Haipeng-Jiang/unit/plots/unit__Assembly.pdf

+ | - 1 | 2 | 3 | 4 1 | 2 | 3 | 4 ABC | ABC Date: KiCad | E.D.A. 8.0.3 Size: A5 | Rev:

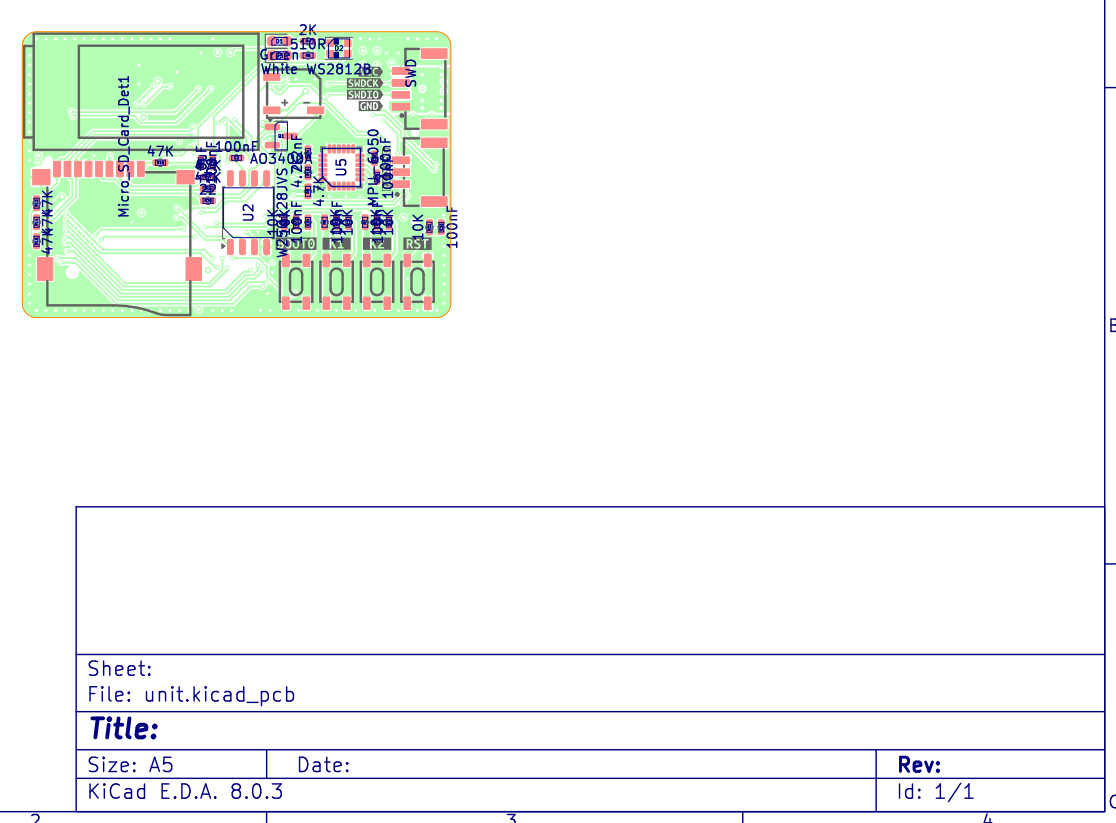
[picture p1: page 1]
Id: 1/1 Title: File: unit.kicad_pcb Sheet:; 4.7KR⁹ 47KR¹³; 100nF C¹ 10KR³Micro_SD_Card_Det1; 100nF C³³ 10KR¹ 100nF C²⁵ 100nF C³⁰; 10KR²² 47KR18; 10KR²³; 10KR² 10KR⁵ 100nF C3; SWDWhite; D3 510RR6 10uFC²⁹; 10KR²¹ 47KR17 22; 100nF C¹⁰ 2.2nF C²⁴ W²⁵Q¹²⁸JVS U²; MPU⁻⁶⁰⁵⁰ U⁵ 4.7KR¹⁰ 47KR¹⁵; 100nF C² Green; 100nF C³⁴ 47KR¹⁴

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

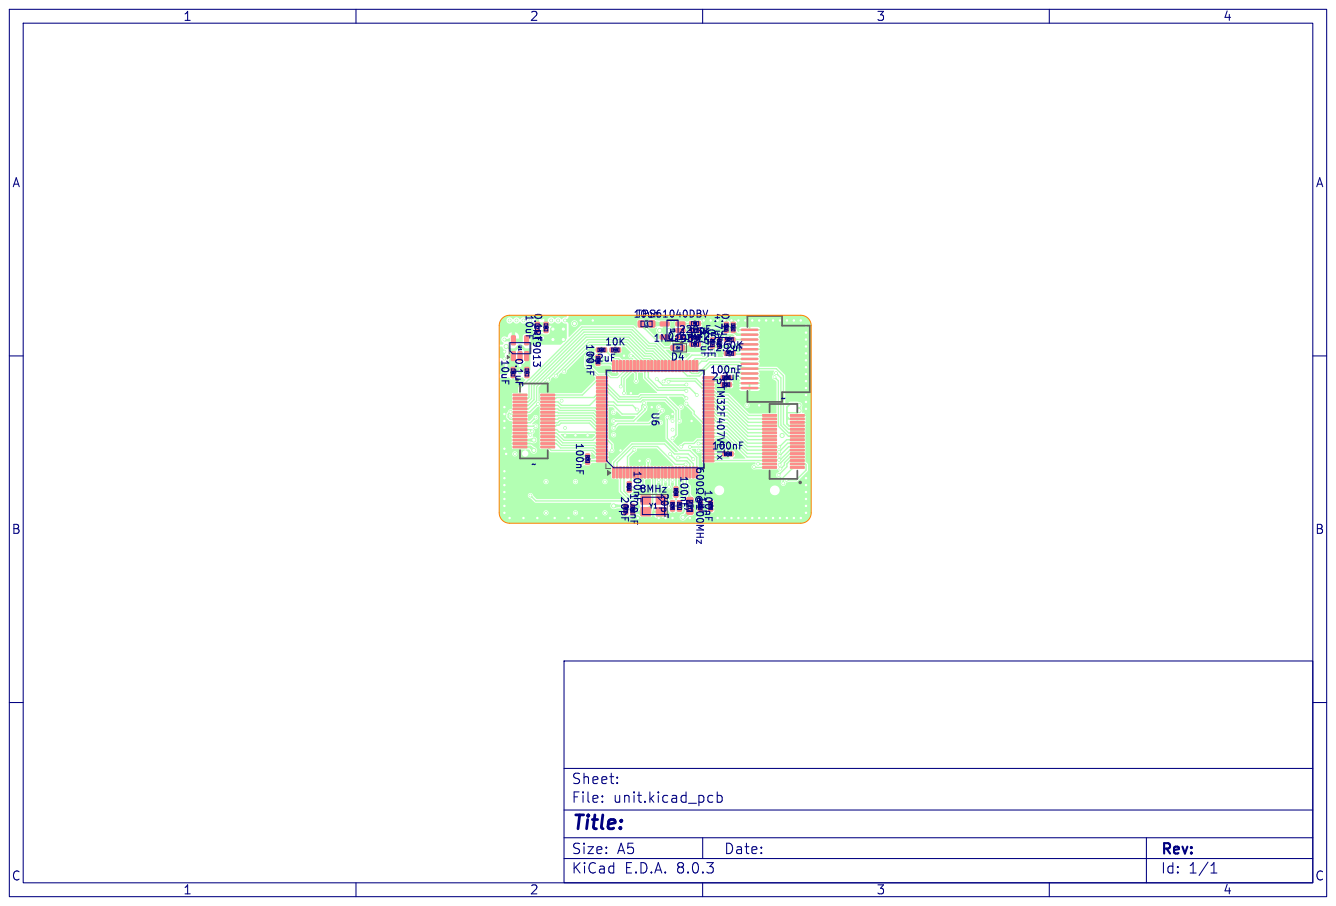
[picture p2: page 2]
