Haipeng-Jiang/unit/unit.pdf

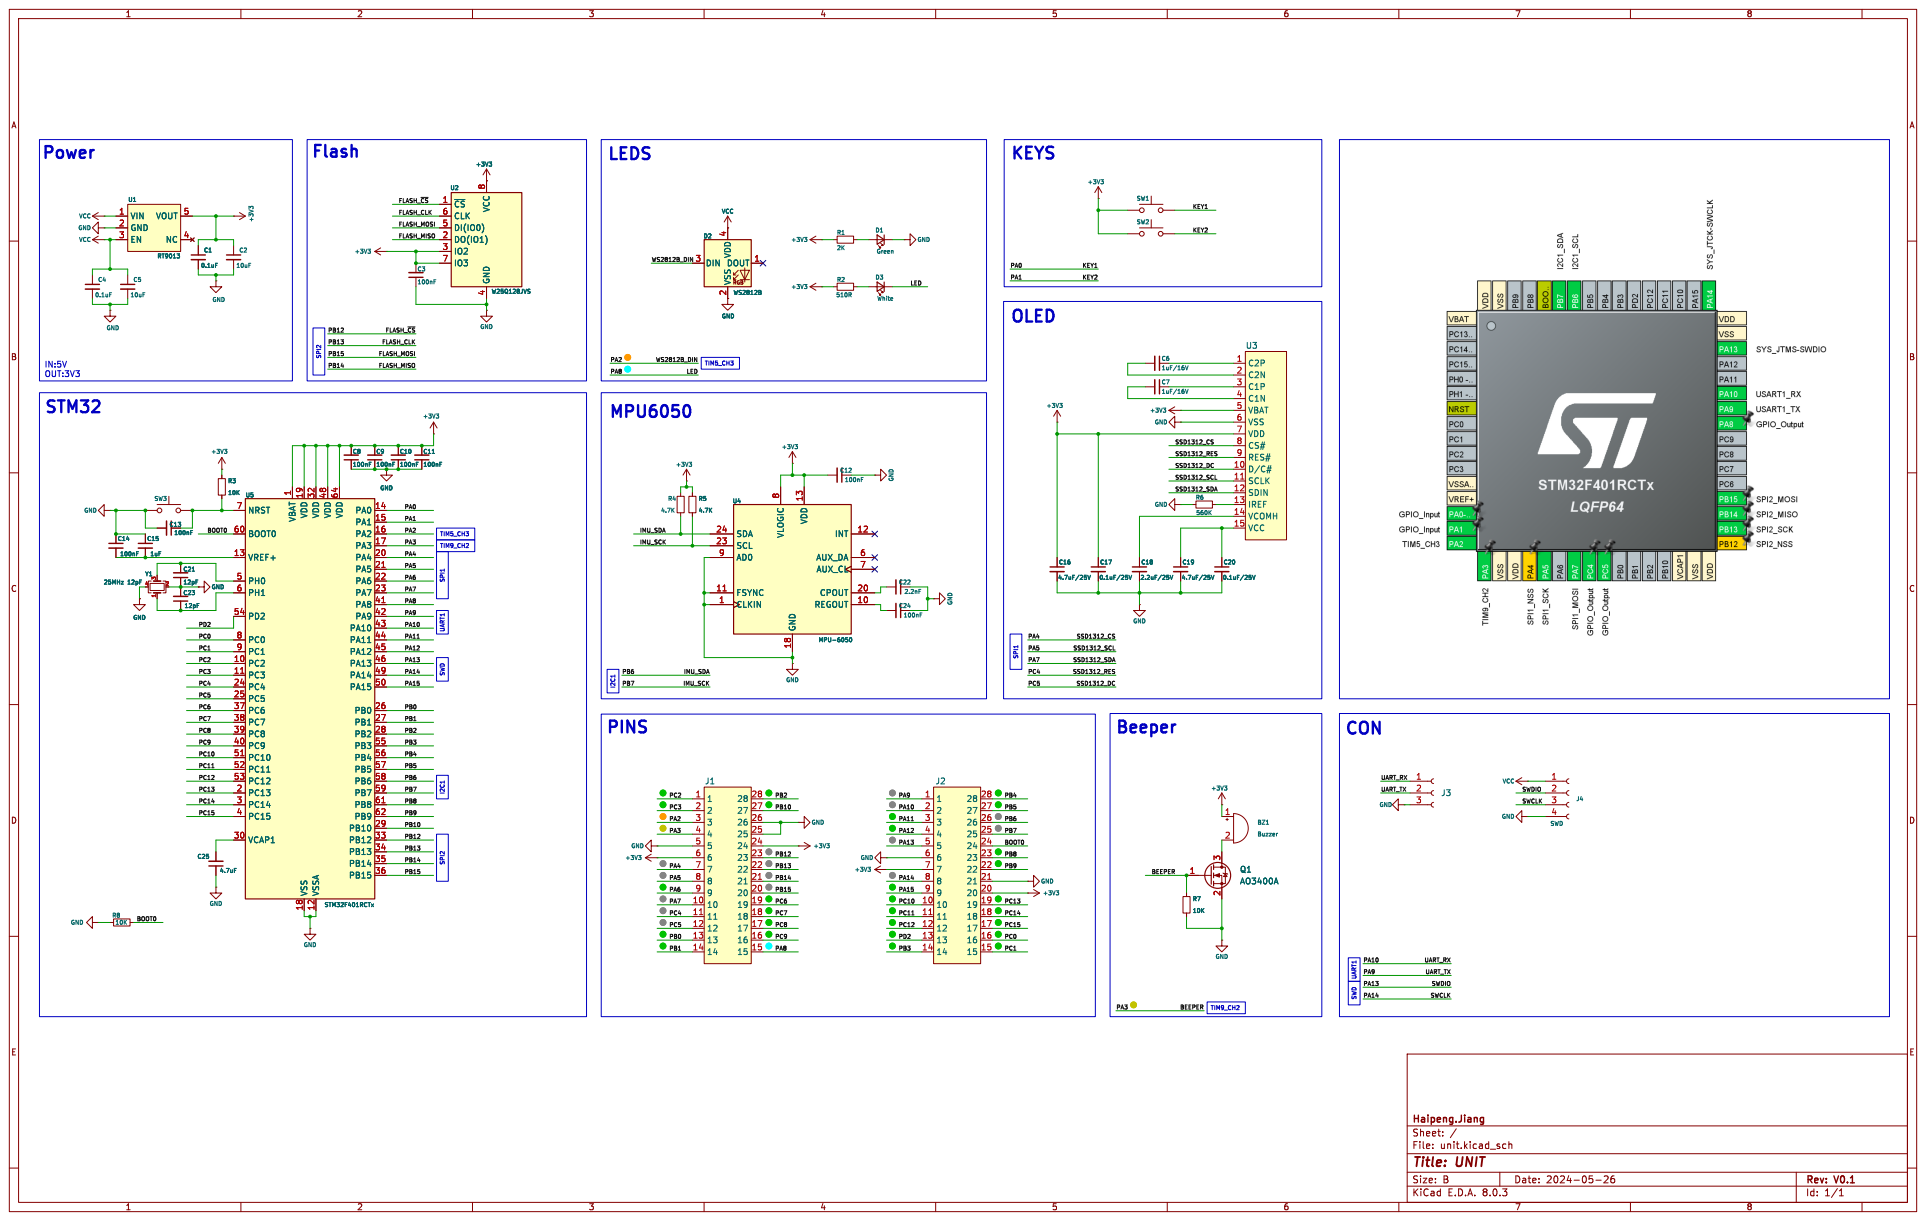
[picture p3: page 1]

File: unit.kicad_sch Sheet: / Haipeng.Jiang +3V3

IREF 13 VCOMH 14 VCC 15 C2N 2 C1P 3 C1N 4 VBAT 5 VSS 6 VDD 7 CS# 8 RES# 9 U3
