Haipeng-Jiang/unit/unit.kicad_pcb

## KiCad design unit.kicad_pcb (2024-08-25)

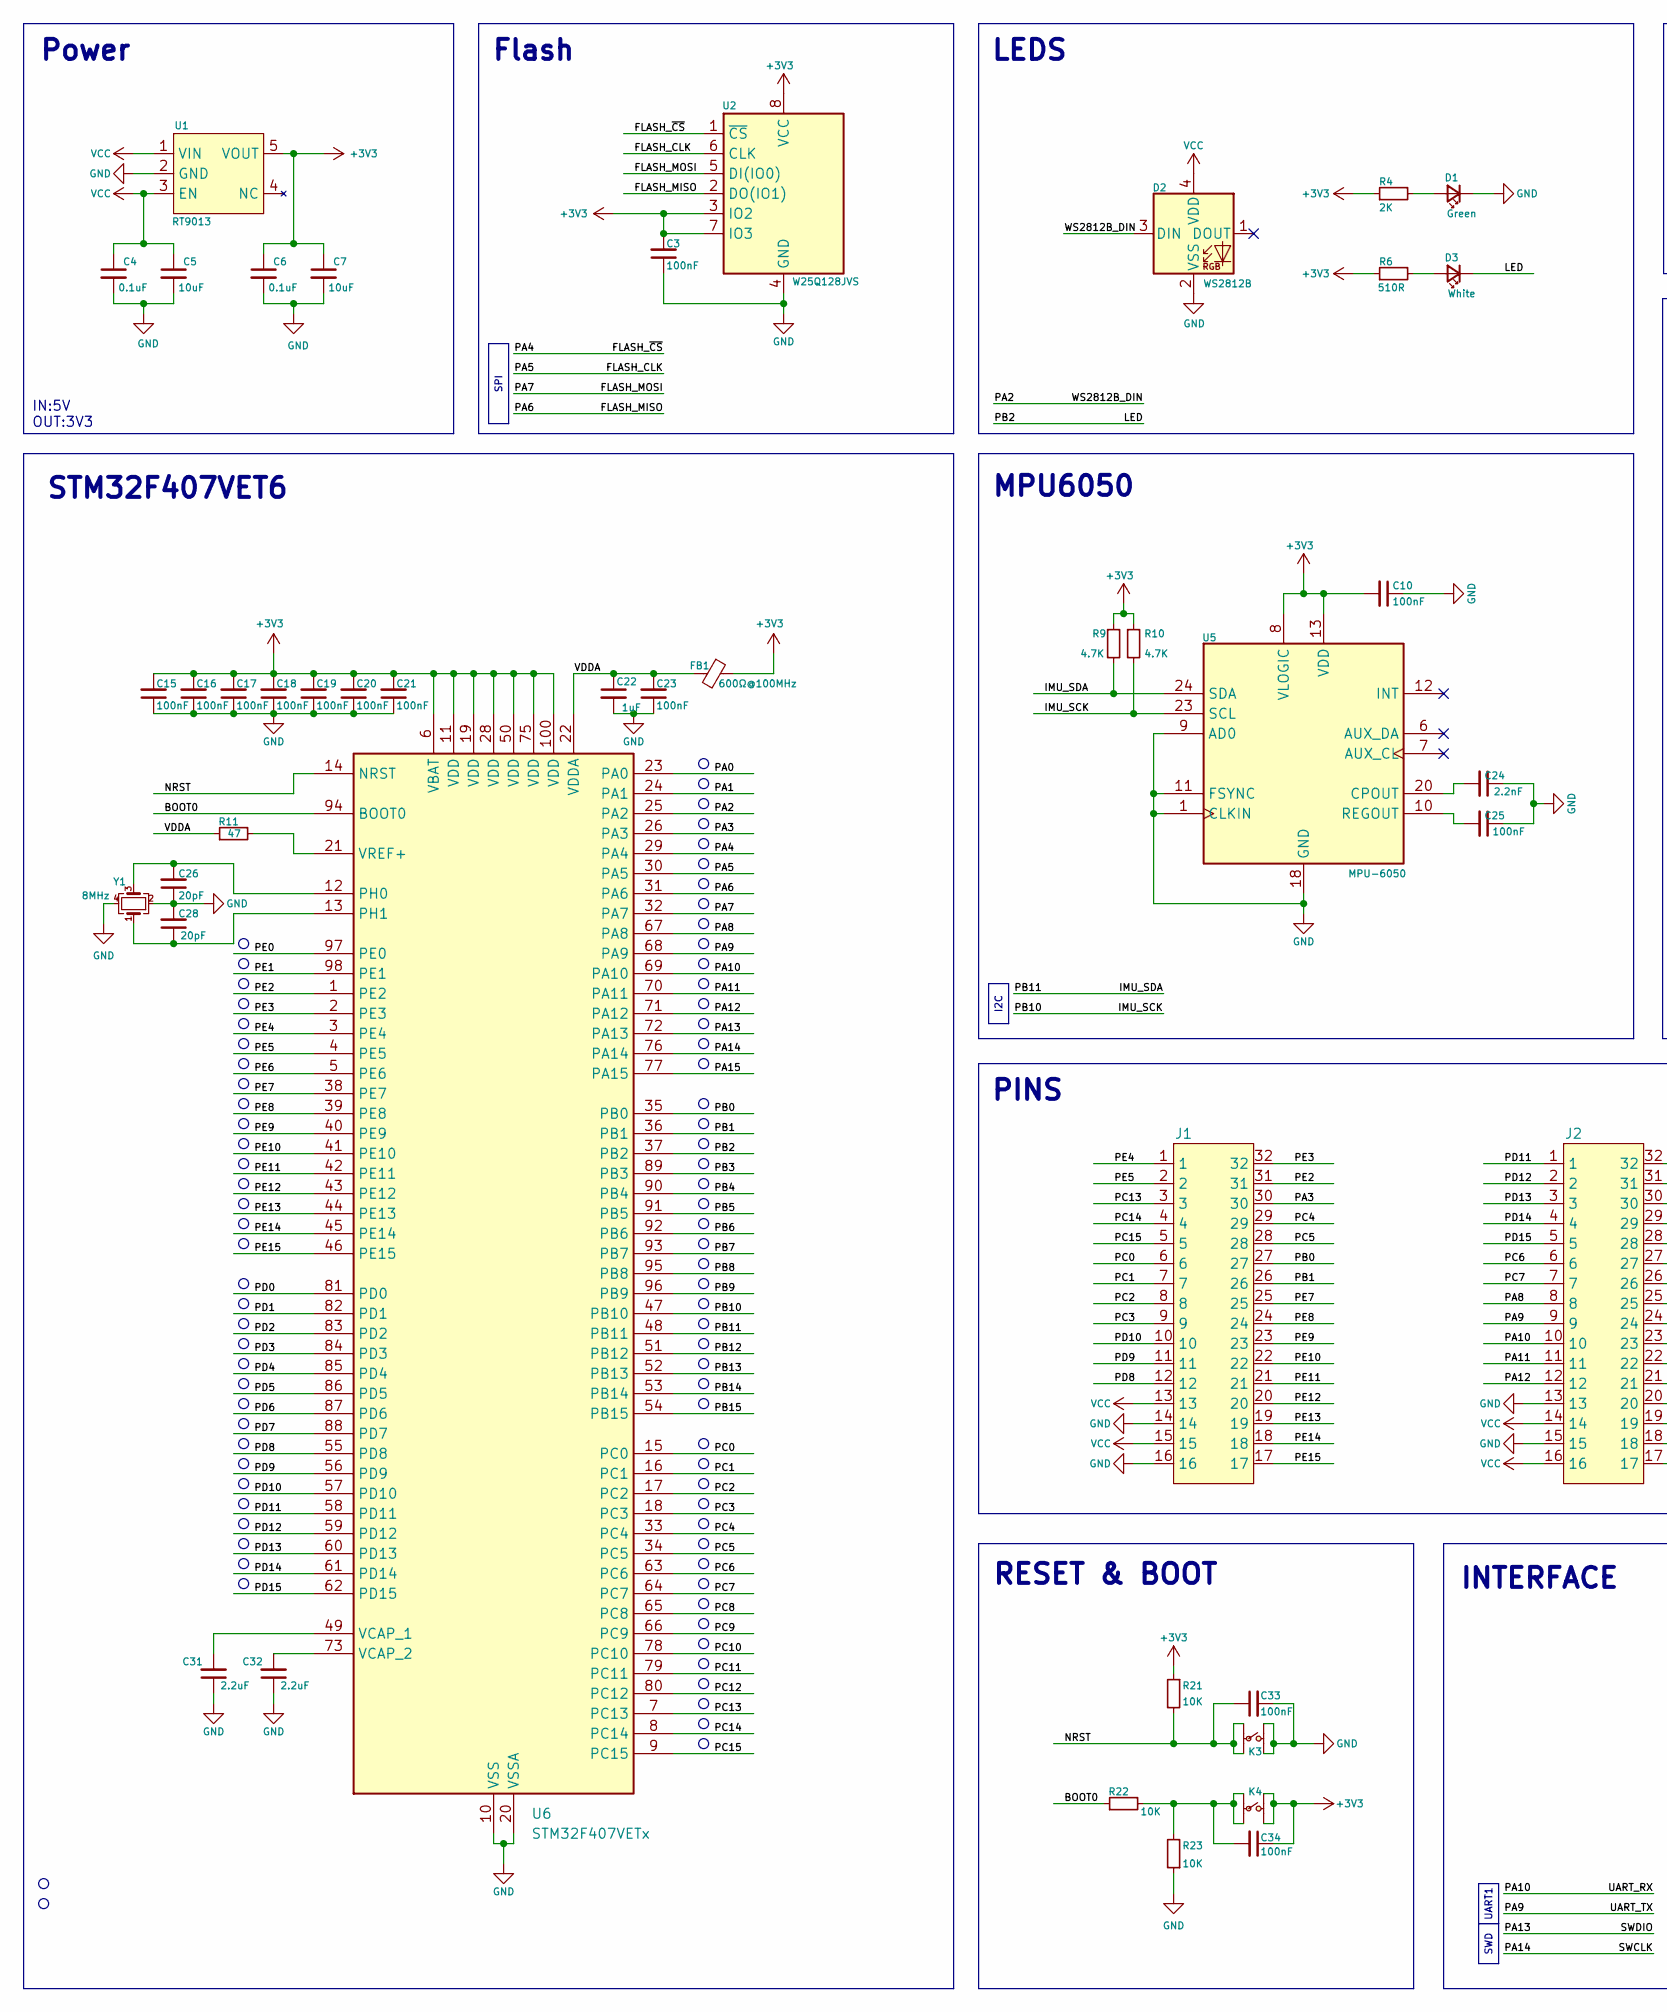
[picture p4: schematic unit.kicad_sch, part in row 1, column 1]

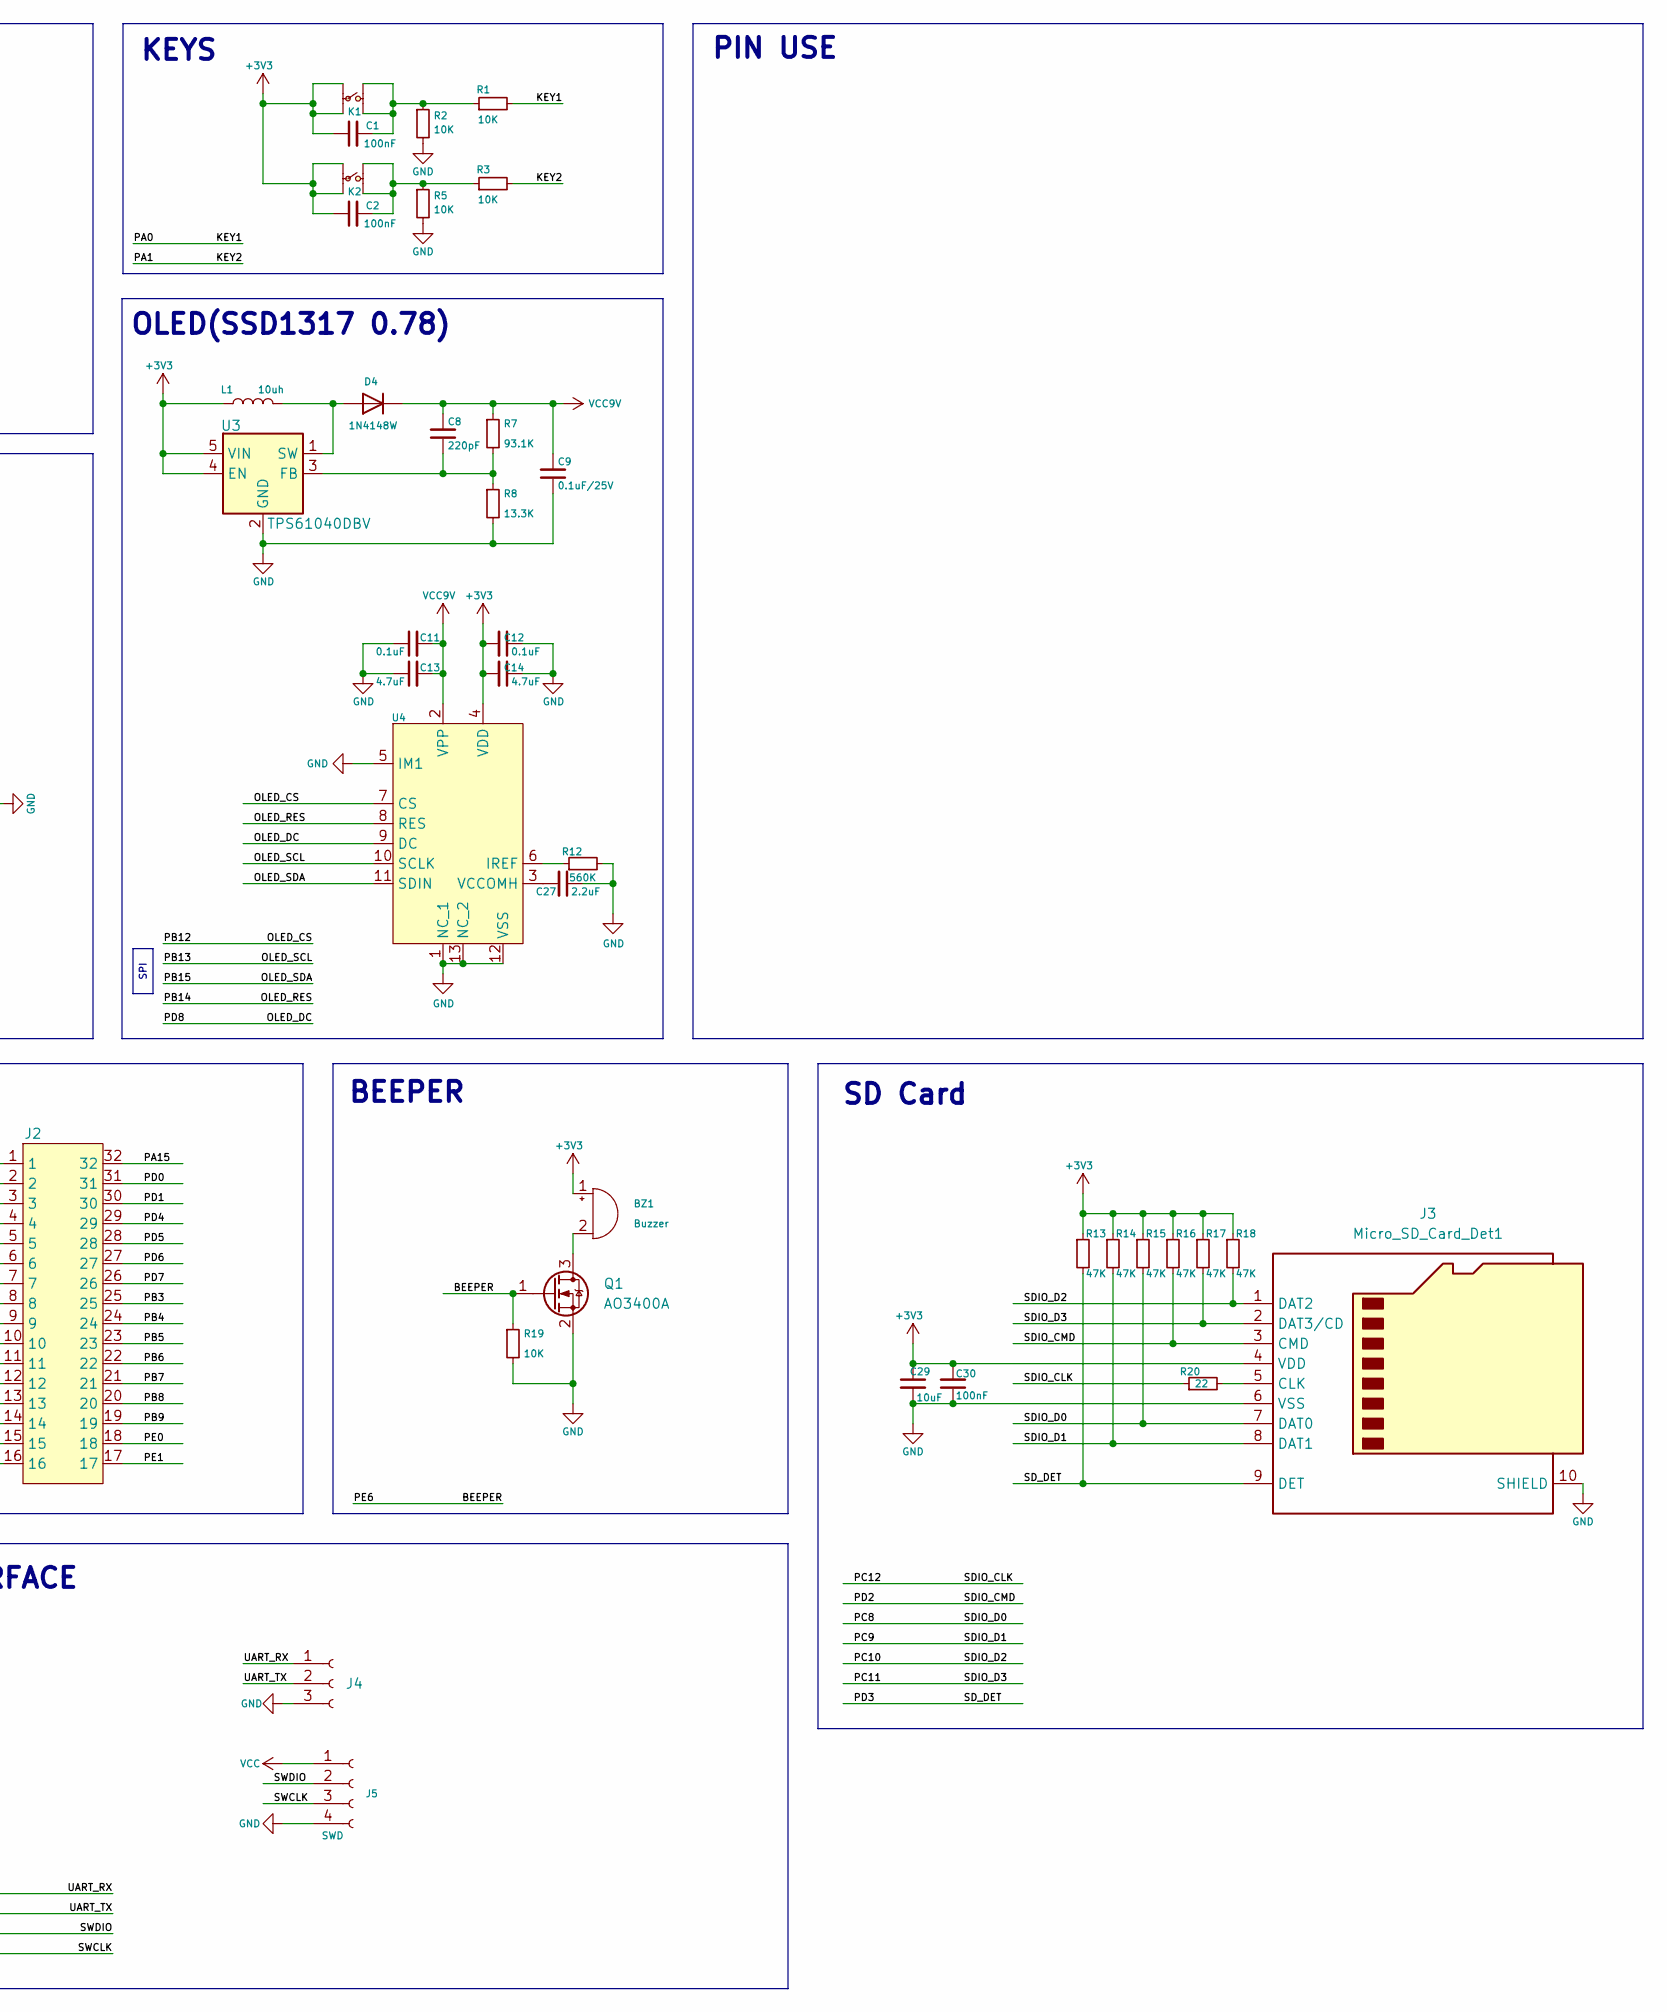
[picture p5: schematic unit.kicad_sch, part in row 1, column 2]

Parts:
BZ1: Buzzer; BUZ-SMD_L5.0-W5.5-P4.60
C1, C2, C3, C10, C15, C16, C17, C18, C19, C20, C21, C23, C25, C30, C33, C34: 100nF; C_0402_1005Metric
C4, C6, C11, C12: 0.1uF; C_0402_1005Metric
C5, C7, C29: 10uF; C_0402_1005Metric
C8: 220pF; C_0402_1005Metric
C9: 0.1uF/25V; C_0402_1005Metric
C13, C14: 4.7uF; C_0402_1005Metric
C22: 1uF; C_0402_1005Metric
C24: 2.2nF; C_0402_1005Metric
C26, C28: 20pF; C_0402_1005Metric
C27, C31, C32: 2.2uF; C_0402_1005Metric
D1: Green; LED_0603_1608Metric
D2: WS2812B; LED_WS2812B-2020_PLCC4_2.0x2.0mm
D3: White; LED_0603_1608Metric
D4: 1N4148W; D_SOD-523
FB1: 600Ω@100MHz; L_0603_1608Metric
J1, J2: M_32PIN
J3: Micro_SD_Card_Det1; TF-SMD_TF-15-15
J4: Conn_01x03_Socket; CONN-SMD_3P-P1.25_JUSHUO_GH125-S03DCA-00
J5: SWD; CONN-SMD_4P-P1.27_GH125-S04DCA-00
K1, K2, K3, K4: SW-SMD_4P-L4.2-W3.3-P2.15-LS5.1
L1: 10uh; L_0603_1608Metric
Q1: AO3400A; SOT-23
R1, R2, R3, R5, R19, R21, R22, R23: 10K; R_0402_1005Metric
R4: 2K; R_0402_1005Metric
R6: 510R; R_0402_1005Metric
R7: 93.1K; R_0402_1005Metric
R8: 13.3K; R_0402_1005Metric
R9, R10: 4.7K; R_0402_1005Metric
R11: 47; R_0402_1005Metric
R12: 560K; R_0402_1005Metric
R13, R14, R15, R16, R17, R18: 47K; R_0402_1005Metric
R20: 22; R_0402_1005Metric
U1: RT9013; SOT-23-5
U2: W25Q128JVS; SOIC-8_5.23x5.23mm_P1.27mm
U3: TPS61040DBV; SOT-23-5
U4: oled_0.78_ssd1317
U5: MPU-6050; InvenSense_QFN-24_4x4mm_P0.5mm
U6: STM32F407VETx; LQFP-100_14x14mm_P0.5mm
Y1: 8MHz; Crystal_SMD_3225-4Pin_3.2x2.5mm

Connections:
+3V3: BZ1.1 (+), C1.1, C2.1, C3.2, C6.1, C7.1, C10.2, C12.2, C14.2, C15.2, C16.2, C17.2, C18.2, C19.2, C20.2, C21.2, C29.1, C30.2, C34.1, FB1.1, J3.4 (VDD), K1.3, K1.4, K2.3, K2.4, K4.1, K4.2, L1.1, R4.1, R6.1, R9.1, R10.1, R13.1, R14.1, R15.1, R16.1, R17.1, R18.1, R21.1, U1.5 (VOUT), U2.3 (IO2), U2.7 (IO3), U2.8 (VCC), U3.4 (EN), U3.5 (VIN), U4.4 (VDD), U5.8 (VLOGIC), U5.13 (VDD), U6.6 (VBAT), U6.11 (VDD), U6.19 (VDD), U6.28 (VDD), U6.50 (VDD), U6.75 (VDD), U6.100 (VDD)
/BEEPER: Q1.1 (G), R19.1, U6.5 (PE6)
/BOOT0: R22.1, U6.94 (BOOT0)
/FLASH_CLK: U2.6 (CLK), U6.30 (PA5)
/FLASH_MISO: U2.2 (DO(IO1)), U6.31 (PA6)
/FLASH_MOSI: U2.5 (DI(IO0)), U6.32 (PA7)
/FLASH_~CS: U2.1 (~CS), U6.29 (PA4)
/IMU_SCK: R10.2, U5.23 (SCL), U6.47 (PB10)
/IMU_SDA: R9.2, U5.24 (SDA), U6.48 (PB11)
/KEY1: R1.2, U6.23 (PA0)
/KEY2: R3.2, U6.24 (PA1)
/LED: D3.1 (K), U6.37 (PB2)
/NRST: C33.1, K3.3, K3.4, R21.2, U6.14 (NRST)
/OLED_CS: U4.7 (CS), U6.51 (PB12)
/OLED_DC: J1.12, U4.9 (DC), U6.55 (PD8)
/OLED_RES: U4.8 (RES), U6.53 (PB14)
/OLED_SCL: U4.10 (SCLK), U6.52 (PB13)
/OLED_SDA: U4.11 (SDIN), U6.54 (PB15)
/PA2: D2.3 (DIN), U6.25 (PA2)
/PA3: J1.30, U6.26 (PA3)
/PA8: J2.8, U6.67 (PA8)
/PA9: J2.9, J4.2, U6.68 (PA9)
/PA10: J2.10, J4.1, U6.69 (PA10)
/PA11: J2.11, U6.70 (PA11)
/PA12: J2.12, U6.71 (PA12)
/PA13: J5.2, U6.72 (PA13)
/PA14: J5.3, U6.76 (PA14)
/PA15: J2.32, U6.77 (PA15)
/PB0: J1.27, U6.35 (PB0)
/PB1: J1.26, U6.36 (PB1)
/PB3: J2.25, U6.89 (PB3)
/PB4: J2.24, U6.90 (PB4)
/PB5: J2.23, U6.91 (PB5)
/PB6: J2.22, U6.92 (PB6)
/PB7: J2.21, U6.93 (PB7)
/PB8: J2.20, U6.95 (PB8)
/PB9: J2.19, U6.96 (PB9)
/PC0: J1.6, U6.15 (PC0)
/PC1: J1.7, U6.16 (PC1)
/PC2: J1.8, U6.17 (PC2)
/PC3: J1.9, U6.18 (PC3)
/PC4: J1.29, U6.33 (PC4)
/PC5: J1.28, U6.34 (PC5)
/PC6: J2.6, U6.63 (PC6)
/PC7: J2.7, U6.64 (PC7)
/PC8: J3.7 (DAT0), R15.2, U6.65 (PC8)
/PC9: J3.8 (DAT1), R14.2, U6.66 (PC9)
/PC10: J3.1 (DAT2), R18.2, U6.78 (PC10)
/PC11: J3.2 (DAT3/CD), R17.2, U6.79 (PC11)
/PC12: R20.1, U6.80 (PC12)
/PC13: J1.3, U6.7 (PC13)
/PC14: J1.4, U6.8 (PC14)
/PC15: J1.5, U6.9 (PC15)
/PD0: J2.31, U6.81 (PD0)
/PD1: J2.30, U6.82 (PD1)
/PD2: J3.3 (CMD), R16.2, U6.83 (PD2)
/PD3: J3.9 (DET), R13.2, U6.84 (PD3)
/PD4: J2.29, U6.85 (PD4)
/PD5: J2.28, U6.86 (PD5)
/PD6: J2.27, U6.87 (PD6)
/PD7: J2.26, U6.88 (PD7)
/PD9: J1.11, U6.56 (PD9)
/PD10: J1.10, U6.57 (PD10)
/PD11: J2.1, U6.58 (PD11)
/PD12: J2.2, U6.59 (PD12)
/PD13: J2.3, U6.60 (PD13)
/PD14: J2.4, U6.61 (PD14)
/PD15: J2.5, U6.62 (PD15)
/PE0: J2.18, U6.97 (PE0)
/PE1: J2.17, U6.98 (PE1)
/PE2: J1.31, U6.1 (PE2)
/PE3: J1.32, U6.2 (PE3)
/PE4: J1.1, U6.3 (PE4)
/PE5: J1.2, U6.4 (PE5)
/PE7: J1.25, U6.38 (PE7)
/PE8: J1.24, U6.39 (PE8)
/PE9: J1.23, U6.40 (PE9)
/PE10: J1.22, U6.41 (PE10)
/PE11: J1.21, U6.42 (PE11)
/PE12: J1.20, U6.43 (PE12)
/PE13: J1.19, U6.44 (PE13)
/PE14: J1.18, U6.45 (PE14)
/PE15: J1.17, U6.46 (PE15)
/VDDA: C22.1, C23.2, FB1.2, R11.1, U6.22 (VDDA)
GND: C3.1, C4.2, C5.2, C6.2, C7.2, C9.1, C10.1, C11.1, C12.1, C13.1, C14.1, C15.1, C16.1, C17.1, C18.1, C19.1, C20.1, C21.1, C22.2, C23.1, C24.1, C25.1, C26.1, C27.1, C28.2, C29.2, C30.1, C31.1, C32.1, C33.2, D1.1 (K), D2.2 (VSS), J1.14, J1.16, J2.13, J2.15, J3.6 (VSS), J3.10 (SHIELD), J4.3, J5.4, K3.1, K3.2, Q1.2 (S), R2.2, R5.2, R8.2, R12.2, R19.2, R23.1, U1.2 (GND), U2.4 (GND), U3.2 (GND), U4.1 (NC_1), U4.5 (IM1), U4.12 (VSS), U4.13 (NC_2), U5.1 (CLKIN), U5.9 (AD0), U5.11 (FSYNC), U5.18 (GND), U6.10 (VSS), U6.20 (VSSA), U6.27 (VSS), U6.74 (VSS), U6.99 (VSS), Y1.2, Y1.4
unnamed: BZ1.2 (-), Q1.3 (D)
unnamed: C1.2, K1.1, K1.2, R1.1, R2.1
unnamed: C2.2, K2.1, K2.2, R3.1, R5.1
unnamed: C34.2, K4.3, K4.4, R22.2, R23.2
unnamed: D1.2 (A), R4.2
unnamed: D3.2 (A), R6.2
unnamed: D4.2 (A), L1.2, U3.1 (SW)
unnamed: J3.5 (CLK), R20.2
unnamed: C8.1, R7.2, R8.1, U3.3 (FB)
unnamed: R12.1, U4.6 (IREF)
unnamed: C27.2, U4.3 (VCCOMH)
unnamed: C24.2, U5.20 (CPOUT)
unnamed: C25.2, U5.10 (REGOUT)
unnamed: C26.2, U6.12 (PH0), Y1.3
unnamed: C28.1, U6.13 (PH1), Y1.1
unnamed: C31.2, U6.49 (VCAP_1)
unnamed: C32.2, U6.73 (VCAP_2)
unnamed: R11.2, U6.21 (VREF+)
VCC: C4.1, C5.1, D2.4 (VDD), J1.13, J1.15, J2.14, J2.16, J5.1, U1.1 (VIN), U1.3 (EN)
VCC9V: C8.2, C9.2, C11.2, C13.2, D4.1 (K), R7.1, U4.2 (VPP)

Notes on the sheet:
UART1
SPI
SWD
I2C
PIN USE
STM32F407VET6
MPU6050
LEDS
IN:5V OUT:3V3
Flash
SD Card
OLED(SSD1317 0.78)
PINS
BEEPER
Power
INTERFACE
KEYS
RESET & BOOT

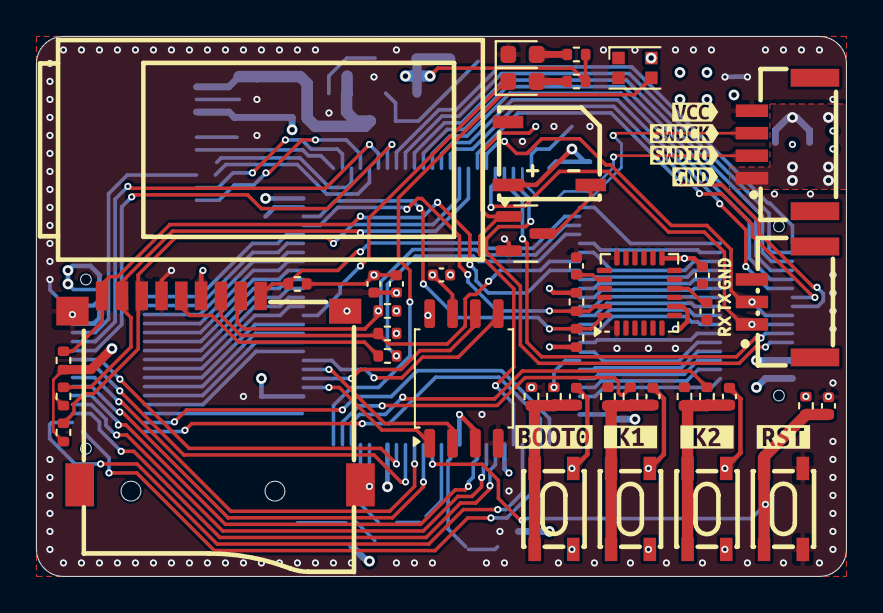
[picture p6: board unit.kicad_pcb from above]

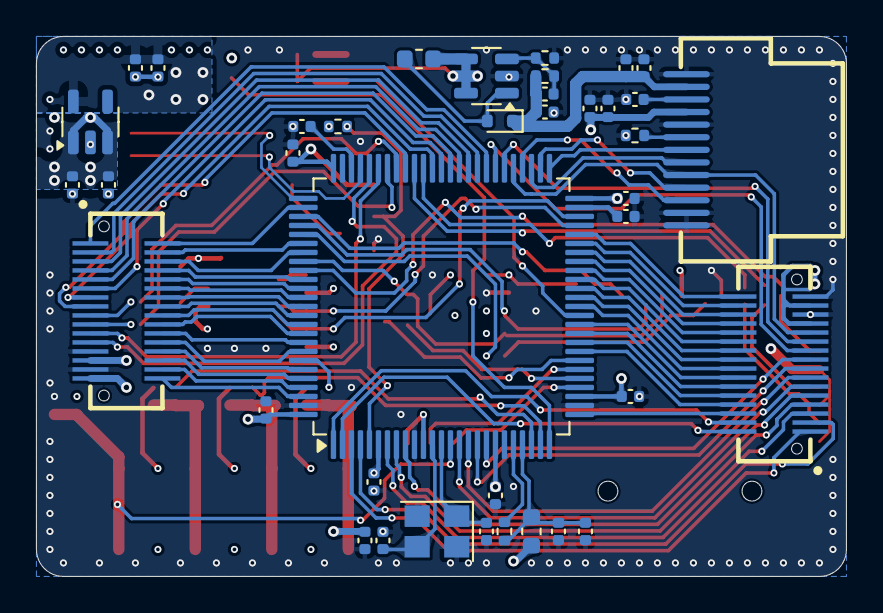
[picture p7: board unit.kicad_pcb from below]

Board: 4 copper layers, 45.0 x 30.0 mm, 89 parts (38 on the bottom side), 105 nets.

Other parts of the board:
kibuzzard-66CADDA5: G***; kibuzzard-66CADDA5
kibuzzard-66CADDDA: G***; kibuzzard-66CADDDA
kibuzzard-66CADE49: G***; kibuzzard-66CADE49
kibuzzard-66CADE69: G***; kibuzzard-66CADE69
kibuzzard-66CADF6D: G***; kibuzzard-66CADF6D
kibuzzard-66CADF7A: G***; kibuzzard-66CADF7A
kibuzzard-66CADF13: G***; kibuzzard-66CADF13
kibuzzard-66CADF25: G***; kibuzzard-66CADF25
